SebRincon/ESP32-C3/Circuit Board/misc/ESP32-C3.png

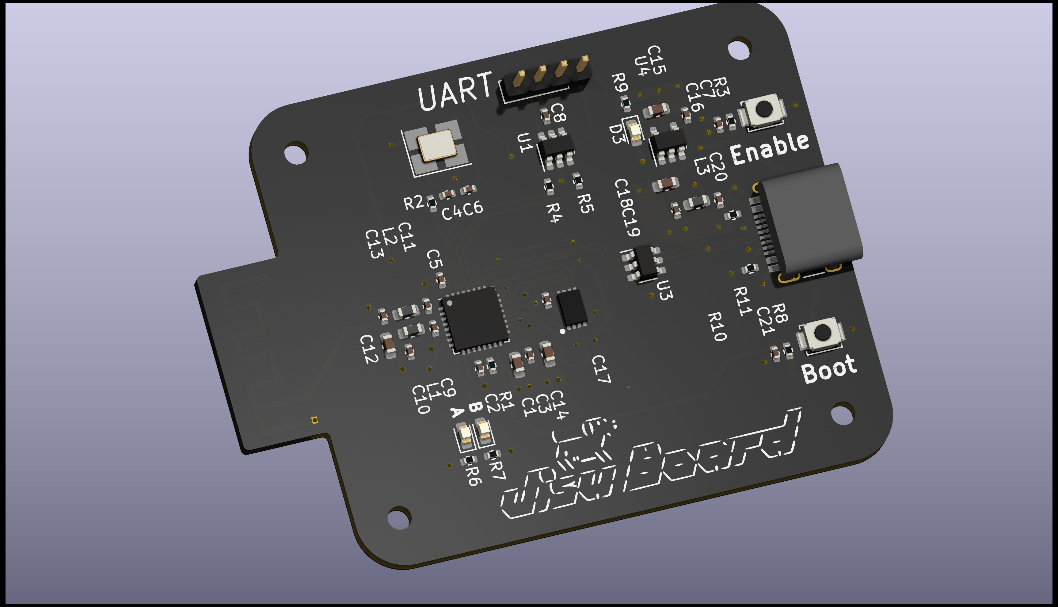
Circuit Board/misc/ESP32-C3.png
