SebRincon/ESP32-C3/Circuit Board/ESP32-C3/ESP32-C3.kicad_pcb

## KiCad design Circuit Board/ESP32-C3/ESP32-C3.kicad_pcb (2023-05-16)

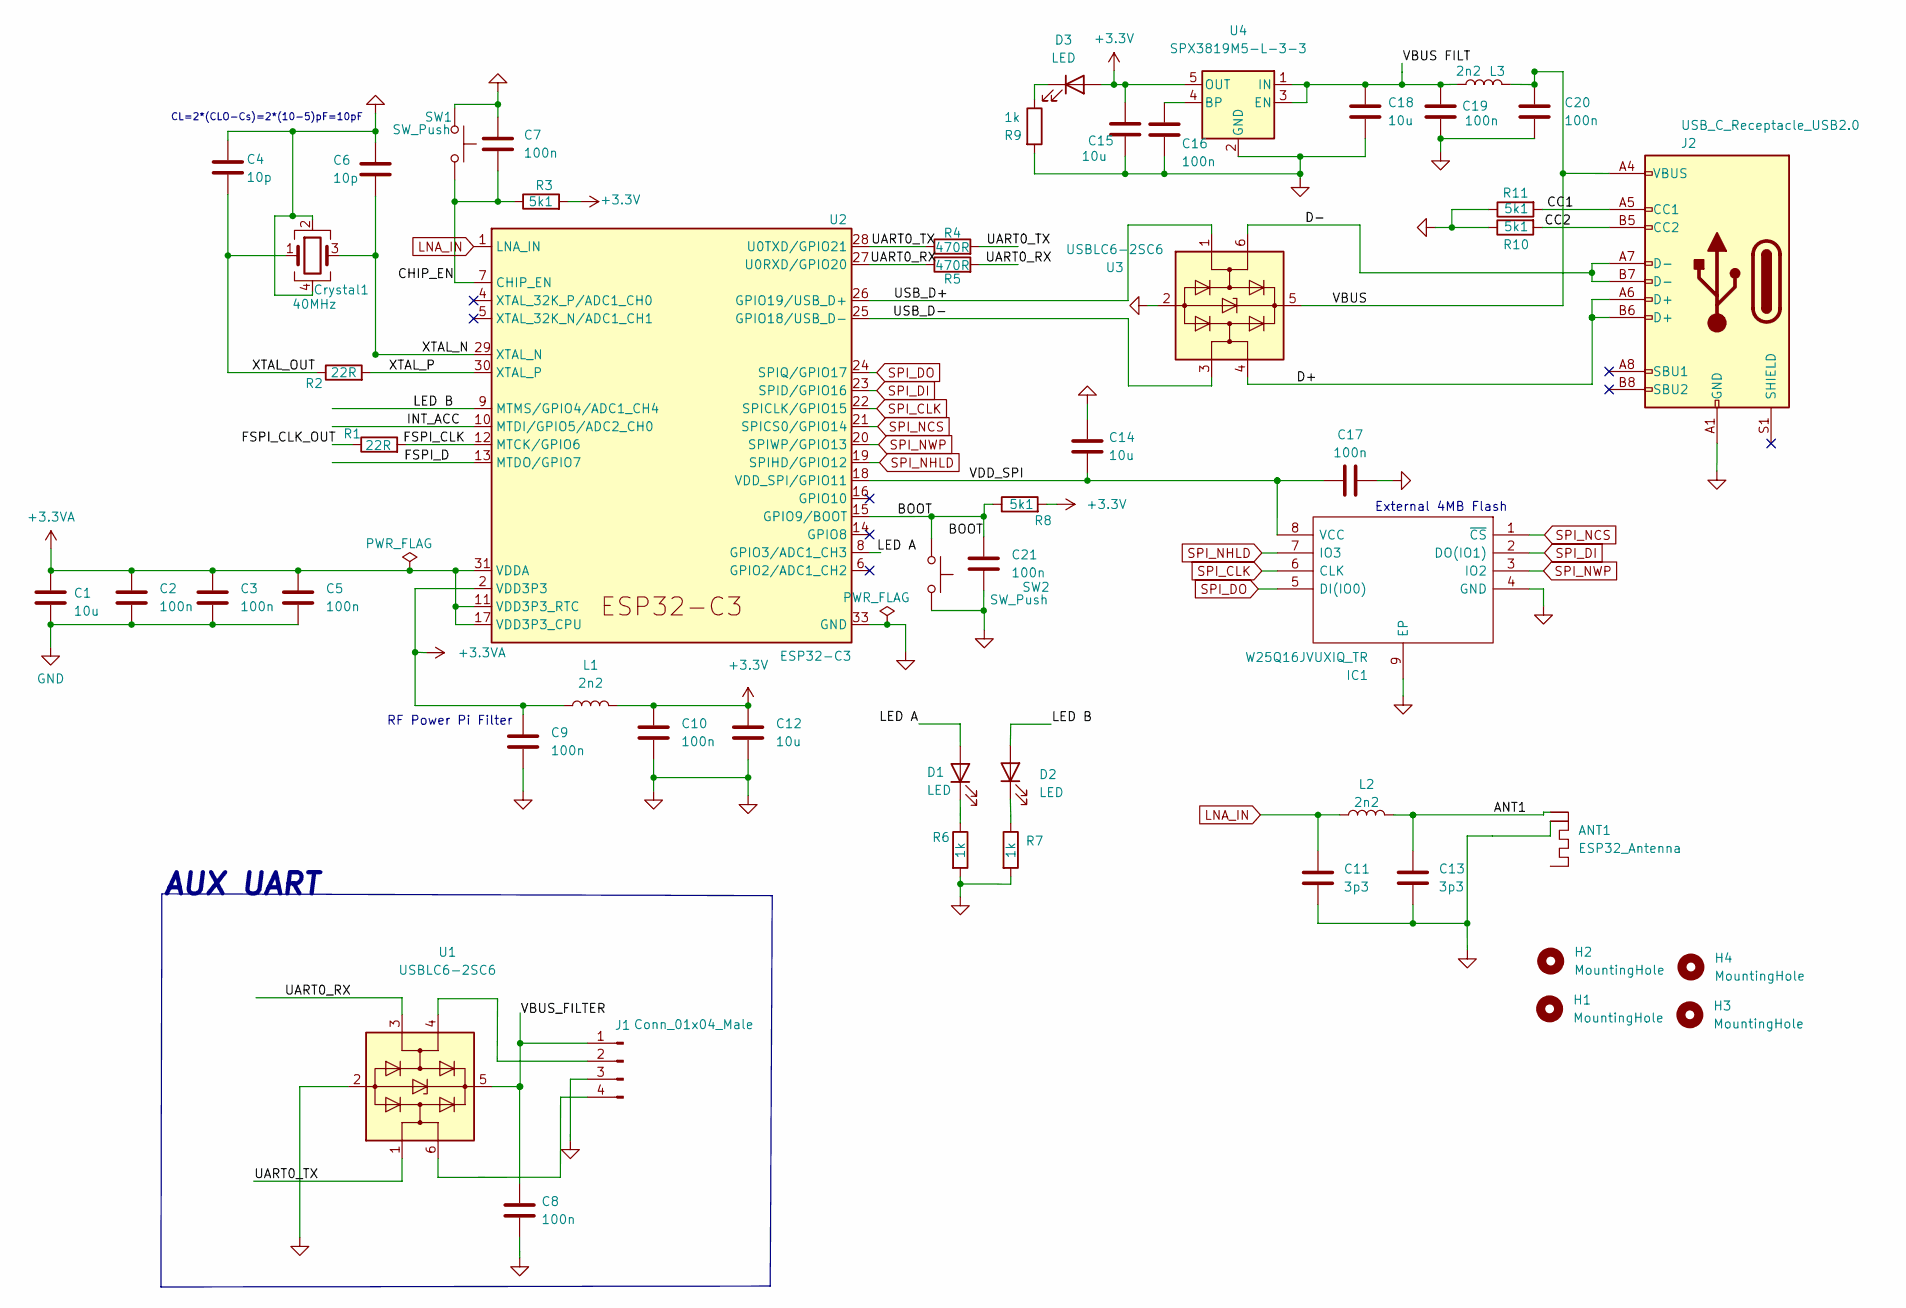
[picture p2: schematic ESP32-C3.kicad_sch]

Parts:
ANT1: ESP32_Antenna; ESPRESSIF_ESP32_MIFA_2.4GHz_Right
C1, C12, C14, C15, C18: 10u; C_0603_1608Metric
C2, C3, C5, C7, C8, C9, C10, C16, C17, C19, C20, C21: 100n; C_0402_1005Metric
C4, C6: 10p; C_0402_1005Metric
C11, C13: 3p3; C_0402_1005Metric
Crystal1: 40MHz; Crystal_SMD_3225-4Pin_3.2x2.5mm_HandSoldering
D1, D2, D3: LED; LED_0603_1608Metric
H1, H2, H3, H4: MountingHole; MountingHole_2.2mm_M2
IC1: W25Q16JVUXIQ_TR; SON50P300X200X60-9N; Mouser Part Number 454-W25Q16JVUXIQTR
J1: Conn_01x04_Male; PinHeader_1x04_P2.00mm_Vertical
J2: USB_C_Receptacle_USB2.0; USB_C_Receptacle_HRO_TYPE-C-31-M-12
L1, L2, L3: 2n2; L_0603_1608Metric
R1, R2: 22R; R_0402_1005Metric
R3, R8, R10, R11: 5k1; R_0402_1005Metric
R4, R5: 470R; R_0402_1005Metric
R6, R7, R9: 1k; R_0402_1005Metric
SW1, SW2: SW_Push; SW_SPST_B3U-1000P
U1, U3: USBLC6-2SC6; SOT-23-6
U2: ESP32-C3; QFN-32-1EP_5x5mm_P0.5mm_EP3.45x3.45mm
U4: SPX3819M5-L-3-3; SOT-23-5

Connections:
+3.3V: C10.1, C12.1, C15.1, D3.2 (A), L1.2, R3.2, R8.2, U4.5 (OUT)
+3.3VA: C1.1, C2.1, C3.1, C5.1, C9.1, L1.1, U2.2 (VDD3P3), U2.3 (VDD3P3), U2.11 (VDD3P3_RTC), U2.17 (VDD3P3_CPU), U2.31 (VDDA), U2.32 (VDDA)
/ANT1: ANT1.1 (Feed), C13.1, L2.2
/BOOT: C21.1, R8.1, SW2.1, U2.15 (GPIO9/BOOT)
/CC1: J2.A5 (CC1), R11.2
/CC2: J2.B5 (CC2), R10.2
/CHIP_EN: C7.2, R3.1, SW1.2, U2.7 (CHIP_EN)
/D+: J2.A6 (D+), J2.B6 (D+), U3.4 (I/O2)
/D-: J2.A7 (D-), J2.B7 (D-), U3.6 (I/O1)
/FSPI_CLK: R1.2, U2.12 (MTCK/GPIO6)
/FSPI_CLK_OUT: R1.1
/FSPI_D: U2.13 (MTDO/GPIO7)
/INT_ACC: U2.10 (MTDI/GPIO5/ADC2_CH0)
/LED A: D1.2 (A), U2.8 (GPIO3/ADC1_CH3); also elsewhere on the board
/LED B: D2.2 (A), U2.9 (MTMS/GPIO4/ADC1_CH4); also elsewhere on the board
/UART0_RX: R5.1, R5.2, U1.3 (I/O2), U2.27 (U0RXD/GPIO20)
/UART0_TX: R4.1, R4.2, U1.1 (I/O1), U2.28 (U0TXD/GPIO21)
/USB_D+: U2.26 (GPIO19/USB_D+), U3.1 (I/O1)
/USB_D-: U2.25 (GPIO18/USB_D-), U3.3 (I/O2)
/VBUS: C20.1, J2.A4 (VBUS), J2.A9 (VBUS), J2.B4 (VBUS), J2.B9 (VBUS), L3.2, U3.5 (VBUS)
/VBUS FILT: C18.1, C19.1, L3.1, U4.1 (IN), U4.3 (EN)
/VBUS_FILTER: C8.1, J1.1, U1.5 (VBUS)
/VDD_SPI: C14.2, C17.1, IC1.8 (VCC), U2.18 (VDD_SPI/GPIO11)
/XTAL_N: C6.2, Crystal1.3, U2.29 (XTAL_N)
/XTAL_OUT: C4.2, Crystal1.1, R2.1
/XTAL_P: R2.2, U2.30 (XTAL_P)
GND: ANT1.2 (GND), C1.2, C2.2, C3.2, C4.1, C5.2, C6.1, C7.1, C8.2, C9.2, C10.2, C11.2, C12.2, C13.2, C14.1, C15.2, C16.2, C17.2, C18.2, C19.2, C20.2, C21.2, Crystal1.2, Crystal1.4, IC1.4 (GND), IC1.9 (EP), J1.3, J2.A1 (GND), J2.A12 (GND), J2.B1 (GND), J2.B12 (GND), R6.2, R7.2, R9.2, R10.1, R11.1, SW1.1, SW2.2, U1.2 (GND), U2.33 (GND), U3.2 (GND), U4.2 (GND)
LNA_IN: C11.1, L2.1, U2.1 (LNA_IN)
unnamed: C16.1, U4.4 (BP)
unnamed 29: D1.1 (K), R6.1; also elsewhere on the board
unnamed 30: D2.1 (K), R7.1; also elsewhere on the board
unnamed: D3.1 (K), R9.1
unnamed: J1.2, U1.4 (I/O2)
unnamed: J1.4, U1.6 (I/O1)
SPI_CLK: IC1.6 (CLK), U2.22 (SPICLK/GPIO15)
SPI_DI: IC1.2 (DO(IO1)), U2.23 (SPID/GPIO16)
SPI_DO: IC1.5 (DI(IO0)), U2.24 (SPIQ/GPIO17)
SPI_NCS: IC1.1 (~CS), U2.21 (SPICS0/GPIO14)
SPI_NHLD: IC1.7 (IO3), U2.19 (SPIHD/GPIO12)
SPI_NWP: IC1.3 (IO2), U2.20 (SPIWP/GPIO13)

Notes on the sheet:
RF Power Pi Filter
External 4MB Flash
AUX UART
CL=2*(CLO-Cs)=2*(10-5)pF=10pF

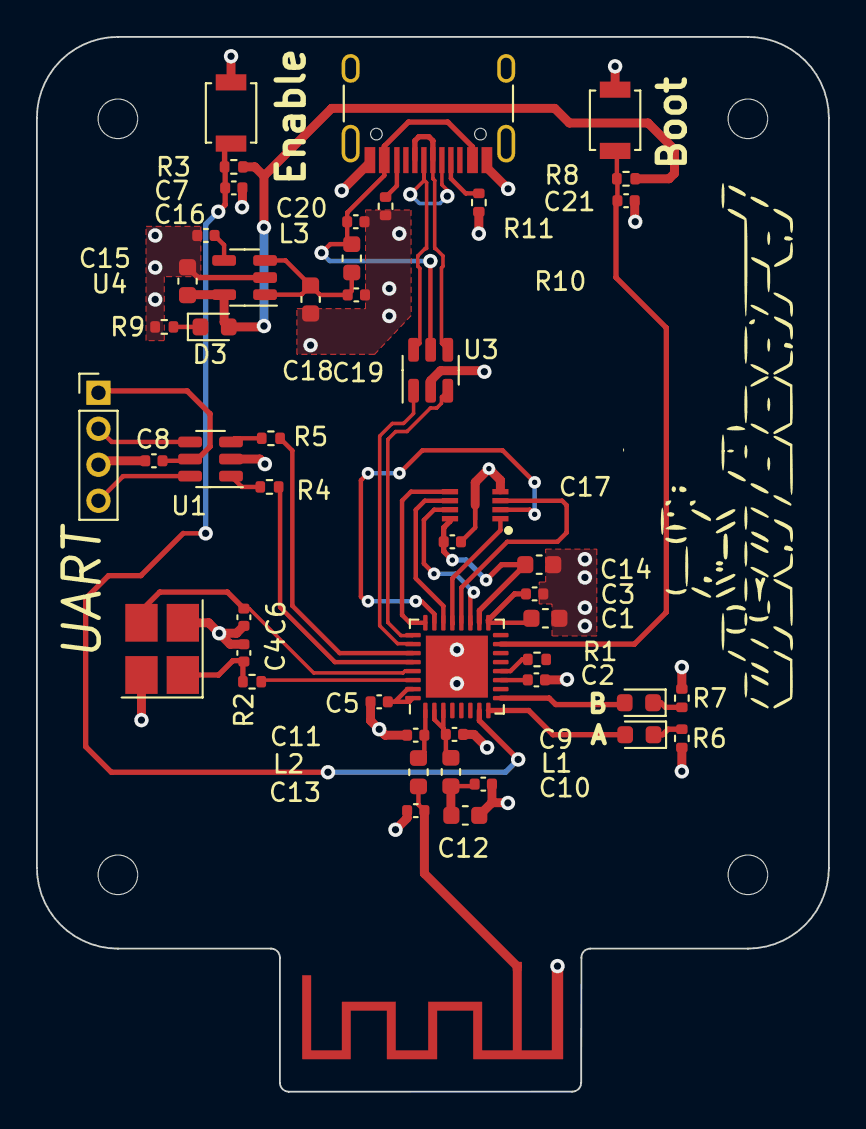
[picture p3: board ESP32-C3.kicad_pcb from above]

Board: 2 copper layers, 44.0 x 58.6 mm, 53 parts (0 on the bottom side), 37 nets.

Other parts of the board:
A: LED; LED_0603_1608Metric
B: LED; LED_0603_1608Metric

Their connections:
/LED A: A.2 (A); also elsewhere on the board
/LED B: B.2 (A); also elsewhere on the board
unnamed 29: A.1 (K); also elsewhere on the board
unnamed 30: B.1 (K); also elsewhere on the board
