SebRincon/ESP32-C3/(commit log)

2023-02-06 Inital Commit
    [ESP32-C3.kicad_pcb]
2023-02-06 Added decoupling capacitors & pi filter
    [ESP32-C3.kicad_sch]
2023-02-06 Added the crystal oscillator
    [ESP32-C3.kicad_sch]
2023-02-06 Added power on switch
    [ESP32-C3.kicad_sch]
2023-02-07 Added external flash memory
    [ESP32-C3.kicad_sch]
2023-02-07 Exposed General Purpose SPI & LED
    [ESP32-C3.kicad_sch]
2023-02-07 Added UART Pinout
    [ESP32-C3.kicad_sch]
2023-02-08 Added power regulator for USB C connector
    [ESP32-C3.kicad_sch]
2023-02-15 Added Auxiliary UART Pins
    [ESP32-C3.kicad_sch]
2023-02-19 Added boot loader switch
    [ESP32-C3.kicad_sch]
2023-02-22 Added RF antenna circuit
    [ESP32-C3.kicad_sch]
2023-02-22 Added RF antenna inductor
    [ESP32-C3.kicad_sch]
2023-02-22 Added LED circuits
    [ESP32-C3.kicad_sch]
2023-02-23 Added comments
    [ESP32-C3.kicad_sch]
2023-02-23 Annotated designators
    [ESP32-C3.kicad_sch]
2023-02-23 Correct ERC errors
    [ESP32-C3.kicad_sch]
2023-05-13 Started PCB routing
    [ESP32-C3.kicad_pcb, ESP32-C3.kicad_sch]
2023-05-15 Finished PCB Layout v1.0
    [ESP32-C3.kicad_pcb, ESP32-C3.kicad_sch]
2023-05-15 Updated PCB Info
    [ESP32-C3.kicad_pcb]
2023-05-15 Generated BOM
    [ESP32-C3.csv]
2023-05-15 Quick PCB Alignment
    [ESP32-C3.kicad_pcb]
2023-05-15 PNP Placement File
    [ESP32-C3-all-pos.csv]
2023-05-15 Gerberfile Creation
    [ESP32-C3-B_Cu.gbr, ESP32-C3-B_Mask.gbr, ESP32-C3-B_Paste.gbr, ESP32-C3-B_Silkscreen.gbr, ESP32-C3-Edge_Cuts.gbr, ESP32-C3-F_Cu.gbr, ESP32-C3-F_Mask.gbr, ESP32-C3-F_Paste.gbr]
2023-05-15 Updated USB-C Silkscreen issue
    [ESP32-C3-B_Cu.gbr, ESP32-C3-B_Mask.gbr, ESP32-C3-B_Paste.gbr, ESP32-C3-B_Silkscreen.gbr, ESP32-C3-Edge_Cuts.gbr, ESP32-C3-F_Cu.gbr, ESP32-C3-F_Mask.gbr, ESP32-C3-F_Paste.gbr]
2023-05-16 Gerbers ZIP + BOM CSV
    [LCSC-BOM.csv]
2023-05-16 Preference Changes
    [ESP32-C3.kicad_pcb]
